Capstone-Group-C1/weight-sensor-pcb/README.md

# weight-sensor-pcb
Converts Load Cell(s) analog signal into CAN signal
