Capstone-Group-C1/weight-sensor-pcb/weight-sensor-pcb/weight-sensor-pcb.kicad_pcb

## KiCad design weight-sensor-pcb/weight-sensor-pcb.kicad_pcb (2026-03-11)

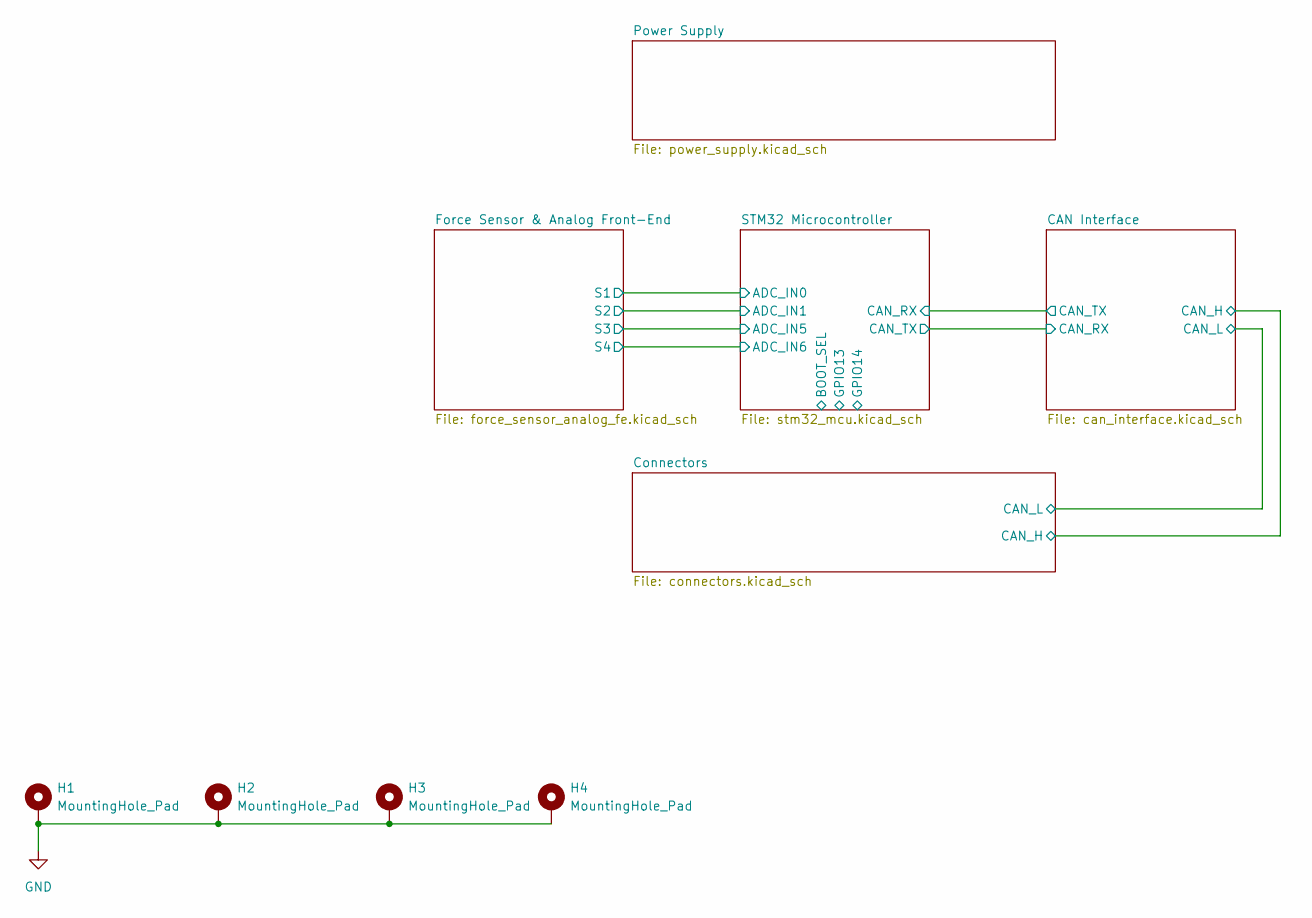
[picture p1: schematic weight-sensor-pcb.kicad_sch, Force Sensor CAN Interface Board]

Parts:
H1, H2, H3, H4: MountingHole_Pad; MountingHole_2.2mm_M2_Pad_Via

Connections:
GND: H1.1, H2.1, H3.1, H4.1; also elsewhere on the board

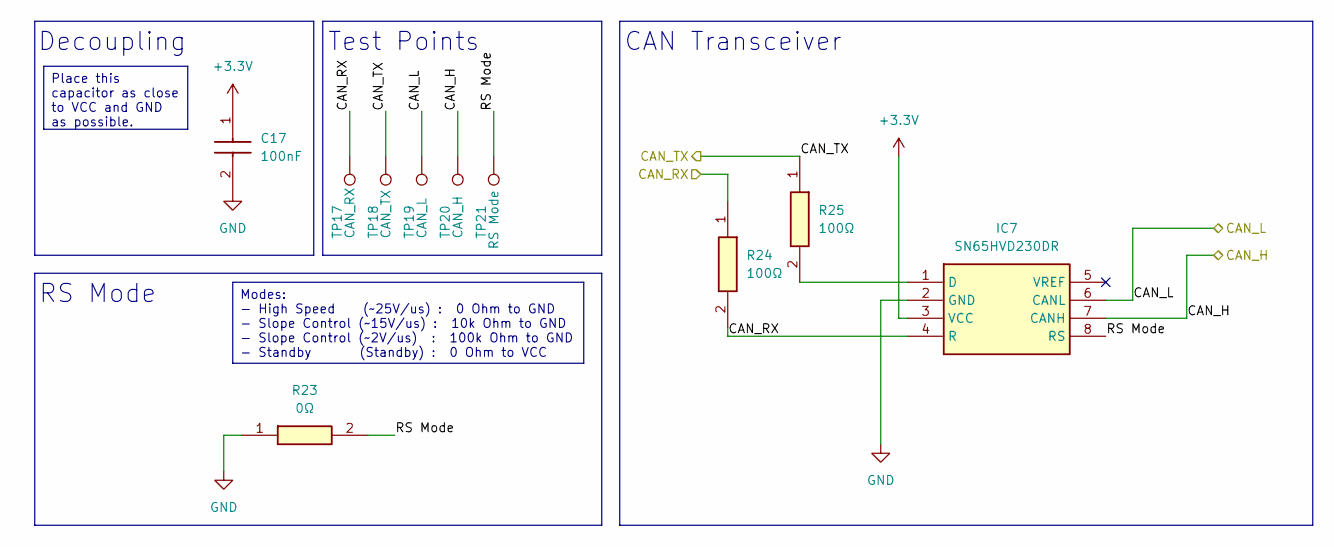
[picture p2: schematic can_interface.kicad_sch, CAN Interface]

Parts:
C17: 100nF; CAPC1005X70N; Manufacturer_Part_Number GRM155R70J104KA01D; Mouser Part Number 81-GRM155R70J104KA1D
IC7: SN65HVD230DR; SOT127P600X175-8N; Mouser Part Number 595-SN65HVD230DR
R23: 0Ω; RESC1608X55N; Manufacturer_Part_Number RC0603JR-070RL; Mouser Part Number 603-RC0603JR-070RL
R24, R25: 100Ω; RESC1608X55N; Manufacturer_Part_Number RC0603FR-07100RL; Mouser Part Number 603-RC0603FR-07100RL
TP17: CAN_RX; TestPoint_Pad_D1.5mm
TP18: CAN_TX; TestPoint_Pad_D1.5mm
TP19: CAN_L; TestPoint_Pad_D1.5mm
TP20: CAN_H; TestPoint_Pad_D1.5mm
TP21: RS Mode; TestPoint_Pad_D1.5mm

Connections:
+3.3V: C17.1, IC7.3 (VCC); also elsewhere on the board
/CAN Interface/CAN_H: IC7.7 (CANH), TP20.1; also elsewhere on the board
/CAN Interface/CAN_L: IC7.6 (CANL), TP19.1; also elsewhere on the board
/CAN Interface/CAN_RX: IC7.4 (R), R24.1, R24.2, TP17.1; also elsewhere on the board
/CAN Interface/CAN_TX: R25.1, TP18.1; also elsewhere on the board
/CAN Interface/RS Mode: IC7.8 (RS), R23.2, TP21.1
GND: C17.2, IC7.2 (GND), R23.1; also elsewhere on the board
unnamed: IC7.1 (D), R25.2

Notes on the sheet:
Decoupling
Test Points
CAN Transceiver
RS Mode
Modes: - High Speed (~25V/us) : 0 Ohm to GND - Slope Control (~15V/us) : 10k Ohm to GND - Slope Control (~2V/us) : 100k Ohm to GND - Standby (Standby) : 0 Ohm to VCC
Place this capacitor as close to VCC and GND as possible.

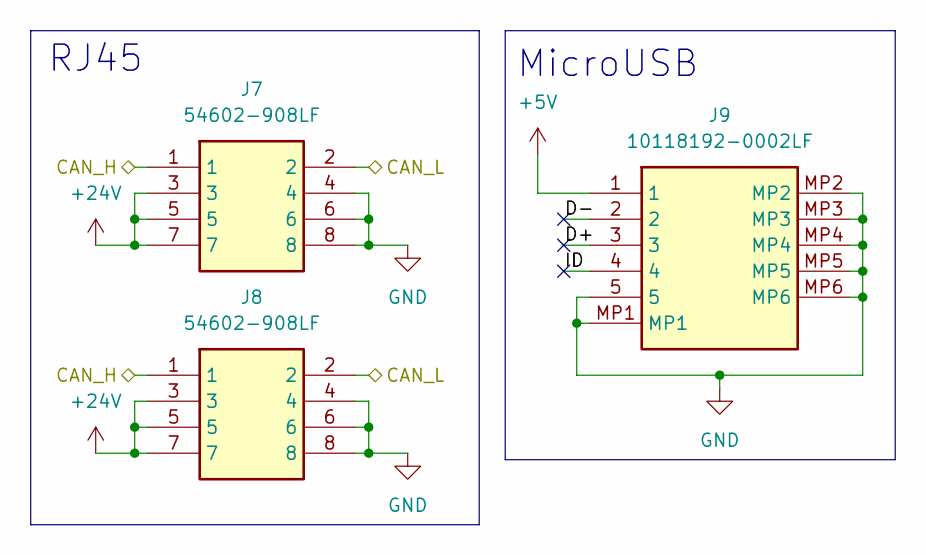
[picture p3: schematic connectors.kicad_sch]

Parts:
J7, J8: 54602-908LF; 54602908LF; Manufacturer_Part_Number 54602-908LF
J9: 10118192-0002LF; 101181920002LF; Manufacturer_Part_Number 10118192-0002LF

Connections:
+5V: J9.1; also elsewhere on the board
+24V: J7.3, J7.5, J7.7, J8.3, J8.5, J8.7; also elsewhere on the board
/CAN Interface/CAN_H: J7.1, J8.1; also elsewhere on the board
/CAN Interface/CAN_L: J7.2, J8.2; also elsewhere on the board
/Connectors/D+: J9.3
/Connectors/D-: J9.2
/Connectors/ID: J9.4
GND: J7.4, J7.6, J7.8, J8.4, J8.6, J8.8, J9.5, J9.MP1, J9.MP2, J9.MP3, J9.MP4, J9.MP5, J9.MP6; also elsewhere on the board

Notes on the sheet:
MicroUSB
RJ45

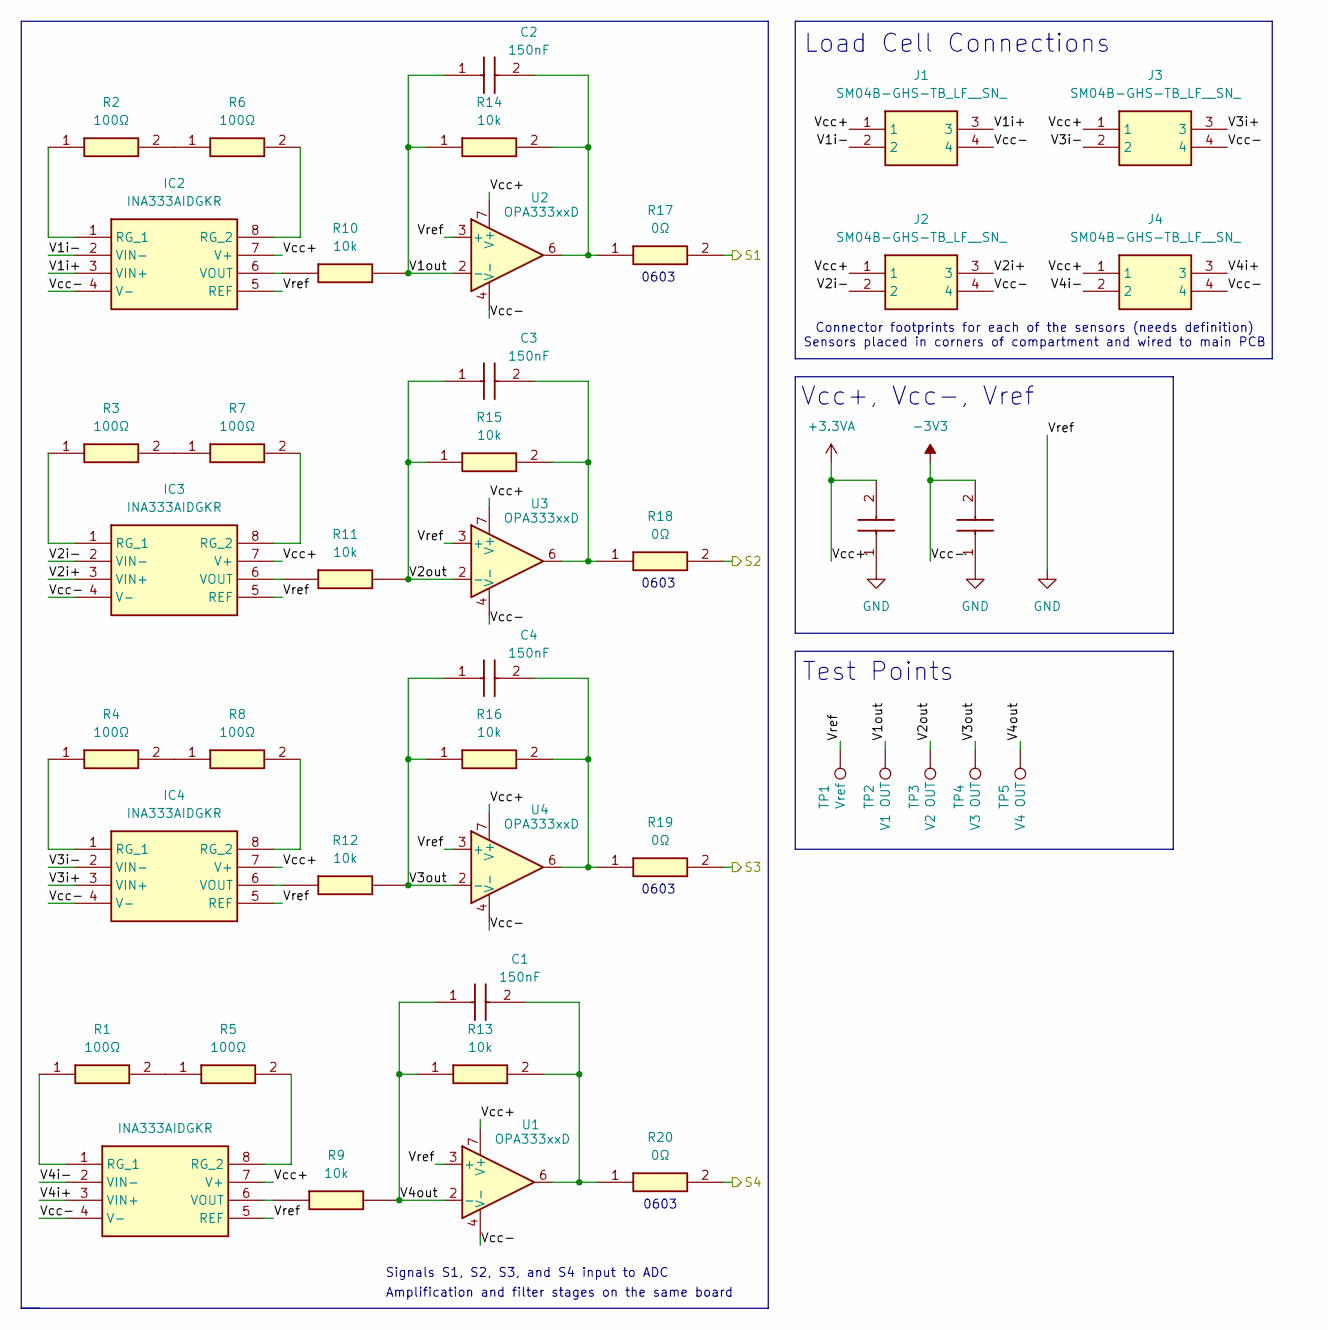
[picture p4: schematic force_sensor_analog_fe.kicad_sch, Force Sensor & Analog Front-End]

Parts:
C1, C2, C3, C4: 150nF; C4532_Commercial; Manufacturer_Part_Number C4532C0G1H154J250KA
C5, C6: 0.1uF; CAPC0603X33N; Mouser Part Number 81-GRM33C71C104KE14D
IC1, IC2, IC3, IC4: INA333AIDGKR; SOP65P490X110-8N; Manufacturer_Part_Number INA333AIDGKR; Mouser Part Number 595-INA333AIDGKR
J1, J2, J3, J4: SM04B-GHS-TB_LF__SN_; SM04B-GHS-TB; Mouser Part Number N/A
R1, R2, R3, R4, R5, R6, R7, R8: 100Ω; RESC1608X55N; Manufacturer_Part_Number RC0603FR-07100RL; Mouser Part Number 603-RC0603FR-07100RL
R9, R10, R11, R12, R13, R14, R15, R16: 10k; RESC1608X55N; Manufacturer_Part_Number RMCF0603FT10K0; Mouser Part Number 708-RMCF0603FT10K0
R17, R18, R19, R20: 0Ω; RESC1608X55N; Manufacturer_Part_Number RC0603JR-070RL; Mouser Part Number 603-RC0603JR-070RL
TP1: Vref; TestPoint_Pad_D1.5mm
TP2: V1 OUT; TestPoint_Pad_D1.5mm
TP3: V2 OUT; TestPoint_Pad_D1.5mm
TP4: V3 OUT; TestPoint_Pad_D1.5mm
TP5: V4 OUT; TestPoint_Pad_D1.5mm
U1, U2, U3, U4: OPA333xxD; SOIC-8_3.9x4.9mm_P1.27mm

Connections:
+3.3VA: C5.2, IC1.7 (V+), IC2.7 (V+), IC3.7 (V+), IC4.7 (V+), J1.1, J2.1, J3.1, J4.1, U1.7 (V+), U2.7 (V+), U3.7 (V+), U4.7 (V+); also elsewhere on the board
-3V3: C6.2, IC1.4 (V-), IC2.4 (V-), IC3.4 (V-), IC4.4 (V-), J1.4, J2.4, J3.4, J4.4, U1.4 (V-), U2.4 (V-), U3.4 (V-), U4.4 (V-); also elsewhere on the board
/Force Sensor & Analog Front-End/V1i+: IC2.3 (VIN+), J1.3
/Force Sensor & Analog Front-End/V1i-: IC2.2 (VIN-), J1.2
/Force Sensor & Analog Front-End/V1out: C2.1, R10.2, R14.1, TP2.1, U2.2 (-)
/Force Sensor & Analog Front-End/V2i+: IC3.3 (VIN+), J2.3
/Force Sensor & Analog Front-End/V2i-: IC3.2 (VIN-), J2.2
/Force Sensor & Analog Front-End/V2out: C3.1, R11.2, R15.1, TP3.1, U3.2 (-)
/Force Sensor & Analog Front-End/V3i+: IC4.3 (VIN+), J3.3
/Force Sensor & Analog Front-End/V3i-: IC4.2 (VIN-), J3.2
/Force Sensor & Analog Front-End/V3out: C4.1, R12.2, R16.1, TP4.1, U4.2 (-)
/Force Sensor & Analog Front-End/V4i+: IC1.3 (VIN+), J4.3
/Force Sensor & Analog Front-End/V4i-: IC1.2 (VIN-), J4.2
/Force Sensor & Analog Front-End/V4out: C1.1, R9.2, R13.1, TP5.1, U1.2 (-)
/STM32 Microcontroller/ADC_IN0: R17.2; also elsewhere on the board
/STM32 Microcontroller/ADC_IN1: R18.2; also elsewhere on the board
/STM32 Microcontroller/ADC_IN5: R19.2; also elsewhere on the board
/STM32 Microcontroller/ADC_IN6: R20.2; also elsewhere on the board
GND: C5.1, C6.1, IC1.5 (REF), IC2.5 (REF), IC3.5 (REF), IC4.5 (REF), TP1.1, U1.3 (+), U2.3 (+), U3.3 (+), U4.3 (+); also elsewhere on the board
unnamed: C1.2, R13.2, R20.1, U1.6
unnamed: C2.2, R14.2, R17.1, U2.6
unnamed: C3.2, R15.2, R18.1, U3.6
unnamed: C4.2, R16.2, R19.1, U4.6
unnamed: IC1.1 (RG_1), R1.1
unnamed: IC1.8 (RG_2), R5.2
unnamed: IC1.6 (VOUT), R9.1
unnamed: IC2.1 (RG_1), R2.1
unnamed: IC2.8 (RG_2), R6.2
unnamed: IC2.6 (VOUT), R10.1
unnamed: IC3.1 (RG_1), R3.1
unnamed: IC3.8 (RG_2), R7.2
unnamed: IC3.6 (VOUT), R11.1
unnamed: IC4.1 (RG_1), R4.1
unnamed: IC4.8 (RG_2), R8.2
unnamed: IC4.6 (VOUT), R12.1
unnamed: R1.2, R5.1
unnamed: R2.2, R6.1
unnamed: R3.2, R7.1
unnamed: R4.2, R8.1

Notes on the sheet:
Load Cell Connections
0603
Signals S1, S2, S3, and S4 input to ADC
Amplification and filter stages on the same board
Connector footprints for each of the sensors (needs definition) Sensors placed in corners of compartment and wired to main PCB
Test Points
Vcc+, Vcc-, Vref

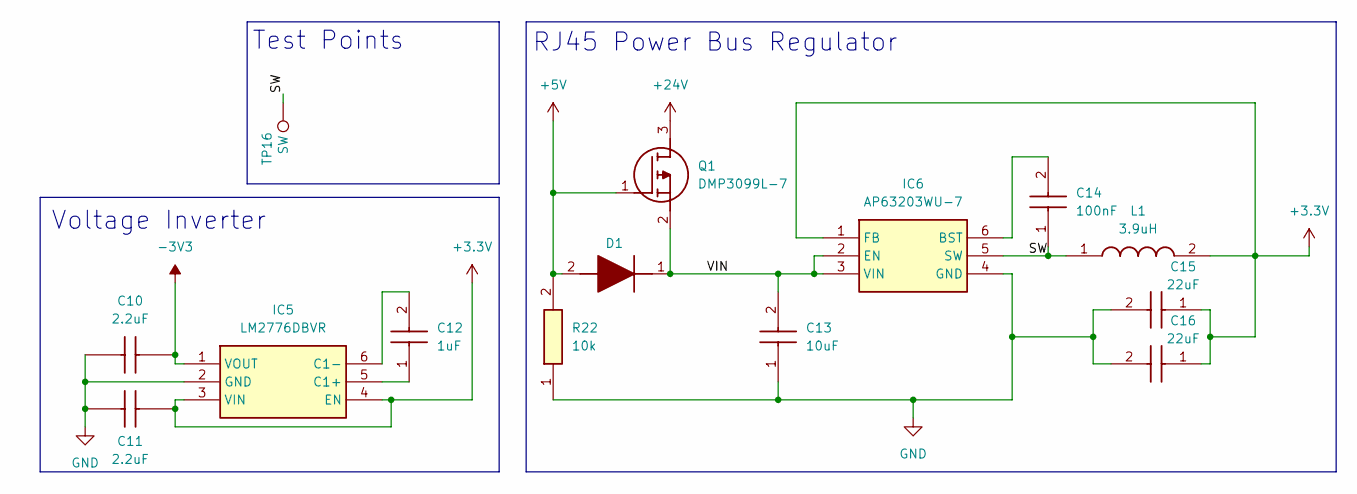
[picture p5: schematic power_supply.kicad_sch, Power Supply]

Parts:
C10, C11: 2.2uF; CAPC1608X90N; Mouser Part Number 81-GRM1885C1H222JA01
C12: 1uF; CAPC1005X70N; Manufacturer_Part_Number GRM155R70J105KA12D; Mouser Part Number 81-GRM155R70J105KA2D
C13: 10uF; CAPC2012X145N; Mouser Part Number 81-GRM21BR61E106KA3K
C14: 100nF; CAPC1005X70N; Manufacturer_Part_Number GRM155R70J104KA01D; Mouser Part Number 81-GRM155R70J104KA1D
C15, C16: 22uF; CAPC3216X190N; Mouser Part Number 963-TMK316BBJ226ML-T
D1: BAT30KFILM; SODFL1608X70N; Manufacturer_Part_Number BAT30KFILM; Mouser Part Number 511-BAT30KFILM
IC5: LM2776DBVR; SOT95P280X145-6N; Manufacturer_Part_Number LM2776DBVR; Mouser Part Number 595-LM2776DBVR
IC6: AP63203WU-7; AP63203WU7; Manufacturer_Part_Number AP63203WU-7; Mouser Part Number 621-AP63203WU-7
L1: 3.9uH; ASPI0628150MT1; Mouser Part Number 815-ASPI-0628-3R9MT1
Q1: DMP3099L-7; SOT96P240X115-3N; Manufacturer_Part_Number DMP3099L-7; Mouser Part Number 621-DMP3099L-7
R22: 10k; RESC1608X55N; Manufacturer_Part_Number RMCF0603FT10K0; Mouser Part Number 708-RMCF0603FT10K0
TP16: SW; TestPoint_Pad_D1.5mm

Connections:
+3.3V: C11.1, C15.1, C16.1, IC5.3 (VIN), IC5.4 (EN), IC6.1 (FB), L1.2; also elsewhere on the board
+5V: D1.2 (A), Q1.1 (G), R22.2; also elsewhere on the board
+24V: Q1.3 (D); also elsewhere on the board
-3V3: C10.1, IC5.1 (VOUT); also elsewhere on the board
/Power Supply/SW: C14.1, IC6.5 (SW), L1.1, TP16.1
/Power Supply/VIN: C13.2, D1.1 (K), IC6.2 (EN), IC6.3 (VIN), Q1.2 (S)
GND: C10.2, C11.2, C13.1, C15.2, C16.2, IC5.2 (GND), IC6.4 (GND), R22.1; also elsewhere on the board
unnamed: C12.1, IC5.5 (C1+)
unnamed: C12.2, IC5.6 (C1-)
unnamed: C14.2, IC6.6 (BST)

Notes on the sheet:
RJ45 Power Bus Regulator
Test Points
Voltage Inverter

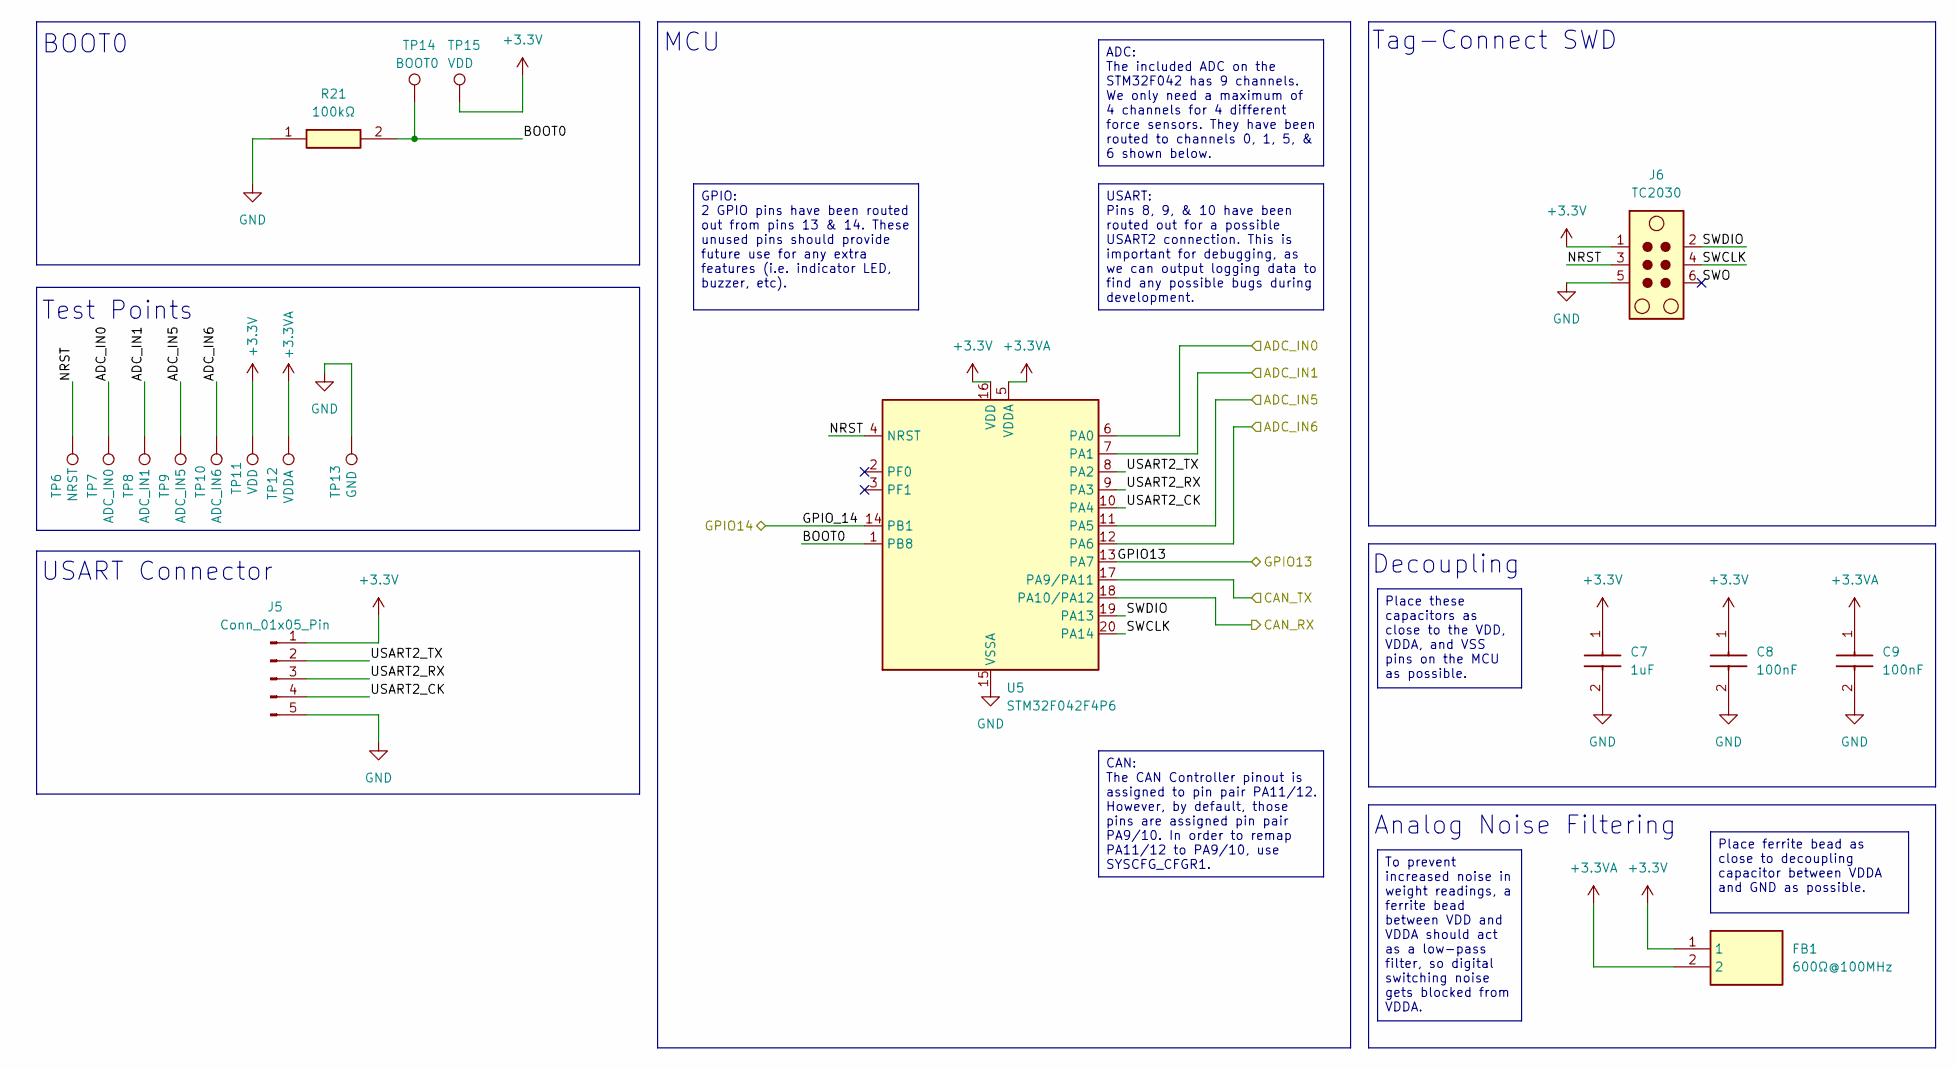
[picture p6: schematic stm32_mcu.kicad_sch, STM32 Microcontroller]

Parts:
C7: 1uF; CAPC1005X70N; Manufacturer_Part_Number GRM155R70J105KA12D; Mouser Part Number 81-GRM155R70J105KA2D
C8, C9: 100nF; CAPC1005X70N; Manufacturer_Part_Number GRM155R70J104KA01D; Mouser Part Number 81-GRM155R70J104KA1D
FB1: 600Ω@100MHz; NFZ15SG152SN10B; Manufacturer_Part_Number BLM15AG601SN1D; Mouser Part Number 81-BLM15AG601SN1D
J5: Conn_01x05_Pin; PinHeader_1x05_P1.27mm_Vertical
J6: TC2030; Tag-Connect_TC2030-IDC-NL_2x03_P1.27mm_Vertical
R21: 100kΩ; RESC1005X40N; Manufacturer_Part_Number RC0402FR-07100KL
TP6: NRST; TestPoint_Pad_D1.5mm
TP7: ADC_IN0; TestPoint_Pad_D1.5mm
TP8: ADC_IN1; TestPoint_Pad_D1.5mm
TP9: ADC_IN5; TestPoint_Pad_D1.5mm
TP10: ADC_IN6; TestPoint_Pad_D1.5mm
TP11, TP15: VDD; TestPoint_Pad_D1.5mm
TP12: VDDA; TestPoint_Pad_D1.5mm
TP13: GND; TestPoint_Pad_D1.5mm
TP14: BOOT0; TestPoint_Pad_D1.5mm
U5: STM32F042F4P6; TSSOP-20_4.4x6.5mm_P0.65mm

Connections:
+3.3V: C7.1, C8.1, FB1.1, J5.1, J6.1, TP11.1, TP15.1, U5.16 (VDD); also elsewhere on the board
+3.3VA: C9.1, FB1.2, TP12.1, U5.5 (VDDA); also elsewhere on the board
/CAN Interface/CAN_RX: U5.17 (PA9/PA11); also elsewhere on the board
/CAN Interface/CAN_TX: U5.18 (PA10/PA12); also elsewhere on the board
/STM32 Microcontroller/ADC_IN0: TP7.1, U5.6 (PA0); also elsewhere on the board
/STM32 Microcontroller/ADC_IN1: TP8.1, U5.7 (PA1); also elsewhere on the board
/STM32 Microcontroller/ADC_IN5: TP9.1, U5.11 (PA5); also elsewhere on the board
/STM32 Microcontroller/ADC_IN6: TP10.1, U5.12 (PA6); also elsewhere on the board
/STM32 Microcontroller/BOOT0: R21.2, TP14.1, U5.1 (PB8)
/STM32 Microcontroller/GPIO13: U5.13 (PA7)
/STM32 Microcontroller/GPIO_14: U5.14 (PB1)
/STM32 Microcontroller/NRST: J6.3, TP6.1, U5.4 (NRST)
/STM32 Microcontroller/SWCLK: J6.4, U5.20 (PA14)
/STM32 Microcontroller/SWDIO: J6.2, U5.19 (PA13)
/STM32 Microcontroller/SWO: J6.6
/STM32 Microcontroller/USART2_CK: J5.4, U5.10 (PA4)
/STM32 Microcontroller/USART2_RX: J5.3, U5.9 (PA3)
/STM32 Microcontroller/USART2_TX: J5.2, U5.8 (PA2)
GND: C7.2, C8.2, C9.2, J5.5, J6.5, R21.1, TP13.1, U5.15 (VSSA); also elsewhere on the board

Notes on the sheet:
Analog Noise Filtering
Test Points
MCU
BOOT0
USART Connector
Decoupling
Tag-Connect SWD
ADC: The included ADC on the STM32F042 has 9 channels. We only need a maximum of 4 channels for 4 different force sensors. They have been routed to channels 0, 1, 5, & 6 shown below.
Place these capacitors as close to the VDD, VDDA, and VSS pins on the MCU as possible.
USART: Pins 8, 9, & 10 have been routed out for a possible USART2 connection. This is important for debugging, as we can output logging data to find any possible bugs during development.
GPIO: 2 GPIO pins have been routed out from pins 13 & 14. These unused pins should provide future use for any extra features (i.e. indicator LED, buzzer, etc).
CAN: The CAN Controller pinout is assigned to pin pair PA11/12. However, by default, those pins are assigned pin pair PA9/10. In order to remap PA11/12 to PA9/10, use SYSCFG_CFGR1.
To prevent increased noise in weight readings, a ferrite bead between VDD and VDDA should act as a low-pass filter, so digital switching noise gets blocked from VDDA.
Place ferrite bead as close to decoupling capacitor between VDDA and GND as possible.

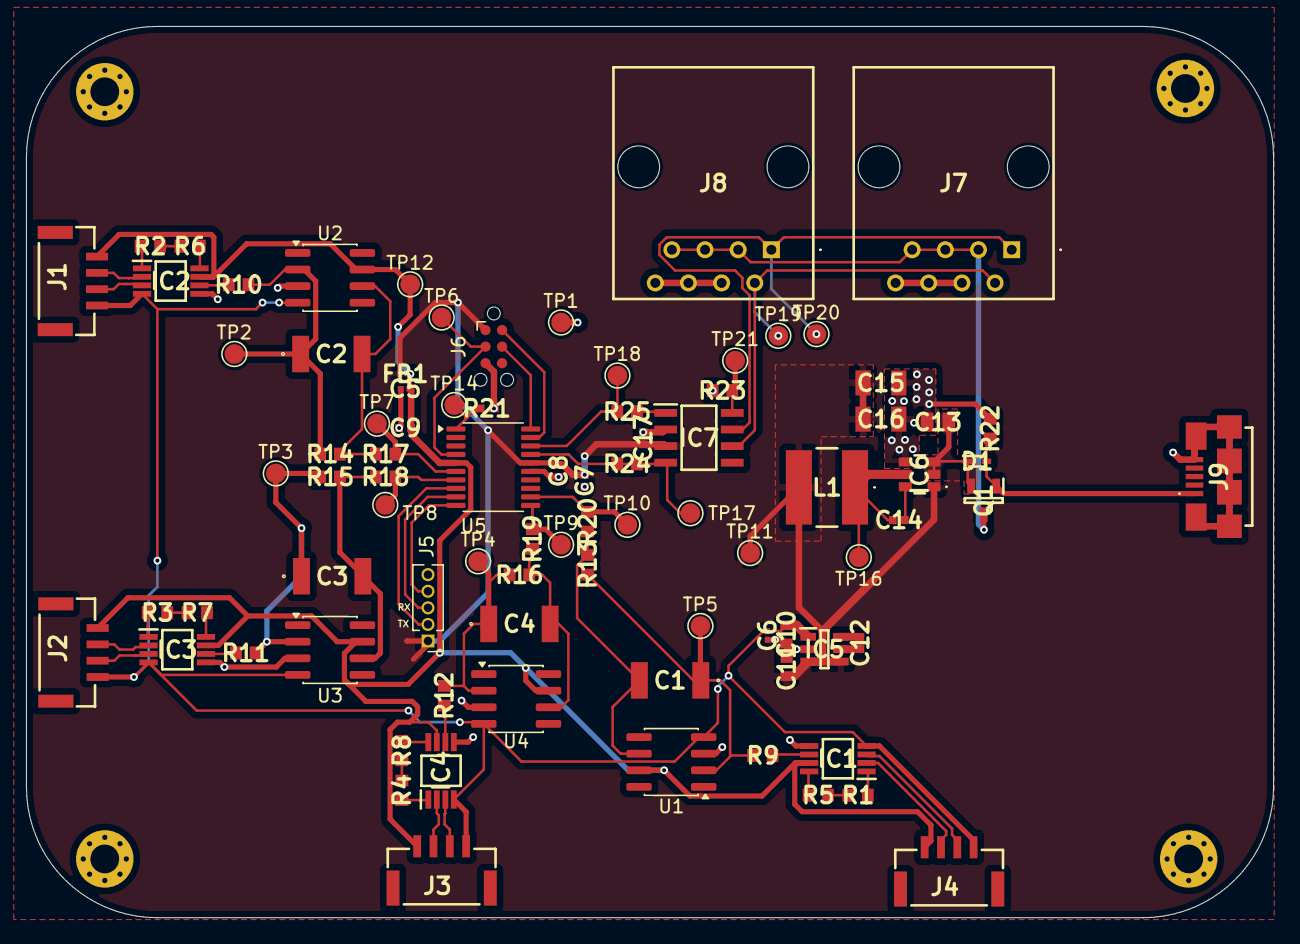
[picture p7: board weight-sensor-pcb.kicad_pcb from above]

Board: 2 copper layers, 95.5 x 68.2 mm, 90 parts (0 on the bottom side), 60 nets.
