Capstone-Group-C1/weight-sensor-pcb/(commit log)

2025-12-21 attempt at force sensor & analog front end schematic
    [can_interface.kicad_sch, force_sensor_analog_fe.kicad_sch, power_supply.kicad_sch, stm32_mcu.kicad_sch, weight-sensor-pcb.kicad_sch]
2025-12-31 Swap MCU, add Library Loader integration
    [stm32_mcu.kicad_sch]
2026-01-28 Add Serial Connection and CAN Transceiver
    [can_interface.kicad_sch, stm32_mcu.kicad_sch]
2026-01-29 Add hierarchial labels to MCU and CAN Interface sheets
    [can_interface.kicad_sch, stm32_mcu.kicad_sch, weight-sensor-pcb.kicad_sch]
2026-01-29 updated tag-connect SWD schematic symbol
    [stm32_mcu.kicad_sch]
2026-02-02 Add decoupling capacitors, current limiting resistors for MCU and CAN Transceiver
    [can_interface.kicad_sch, stm32_mcu.kicad_sch]
2026-02-03 Add ferrite bead between VDDA and VDD, add more notes for MCU
    [stm32_mcu.kicad_sch]
2026-02-03 Add Test points, CAN connector, USART connector
    [can_interface.kicad_sch, connectors.kicad_sch, stm32_mcu.kicad_sch, untitled.kicad_sch, weight-sensor-pcb.kicad_sch]
2026-02-05 Transfered LTSpice analog schematic to its appropriate schematic page
    [force_sensor_analog_fe.kicad_sch]
2026-02-18 initial PCB layout design
    [can_interface.kicad_sch, stm32_mcu.kicad_sch, weight-sensor-pcb.kicad_pcb]
2026-02-18 schematic clean up
    [force_sensor_analog_fe.kicad_sch]
2026-02-18 further schematic clean up
    [force_sensor_analog_fe.kicad_sch]
2026-02-18 git commit
    [force_sensor_analog_fe.kicad_sch]
2026-02-18 update CAN transceiver schematic/layout, use env vars for library paths
    [force_sensor_analog_fe.kicad_sch, stm32_mcu.kicad_sch, weight-sensor-pcb.kicad_pcb]
2026-02-24 finish converter schematic
    [power_supply.kicad_sch]
2026-03-04 Add backup USB power
    [connectors.kicad_sch, power_supply.kicad_sch, stm32_mcu.kicad_sch]
2026-03-09 Add new buck regulator (no component values)
    [power_supply.kicad_sch]
2026-03-10 update new buck regulator schematic
    [power_supply.kicad_sch]
2026-03-10 Add parts to use in 3.3v buck regulator
    [power_supply.kicad_sch]
2026-03-10 replace generic components with specific components
    [connectors.kicad_sch, force_sensor_analog_fe.kicad_sch, weight-sensor-pcb.kicad_pcb]
2026-03-10 replace generic feedback resistors with specific components
    [force_sensor_analog_fe.kicad_sch]
2026-03-10 add more specific components
    [force_sensor_analog_fe.kicad_sch]
2026-03-11 started layout
    [connectors.kicad_sch, force_sensor_analog_fe.kicad_sch, weight-sensor-pcb.kicad_pcb]
2026-03-11 layout progress 1
    [can_interface.kicad_sch, connectors.kicad_sch, force_sensor_analog_fe.kicad_sch, power_supply.kicad_sch, weight-sensor-pcb.kicad_pcb, weight-sensor-pcb.kicad_sch]
2026-03-11 more layout updates, add mounting hole pads to schematic
    [weight-sensor-pcb.kicad_pcb, weight-sensor-pcb.kicad_sch]
2026-03-11 Layout draft complete
    [can_interface.kicad_sch, connectors.kicad_sch, force_sensor_analog_fe.kicad_sch, power_supply.kicad_sch, stm32_mcu.kicad_sch, weight-sensor-pcb.kicad_pcb, weight-sensor-pcb.kicad_sch]
